juanpdeleon/proyecto_motores/Imagenes del proyecto/figura_4.jpg

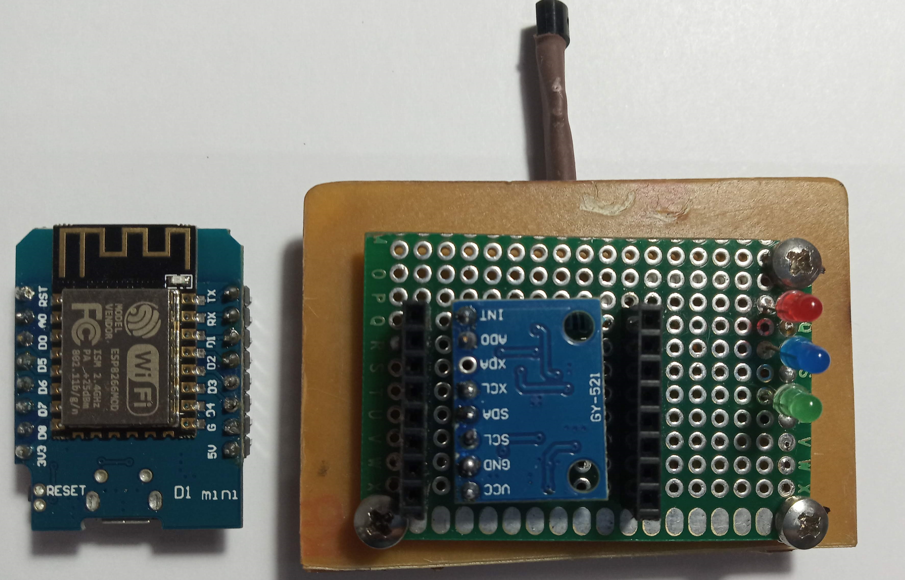
Imagenes del proyecto/figura_4.jpg
