juanpdeleon/proyecto_motores/Imagenes del proyecto/Todas/IMG_20211021_093600.jpg

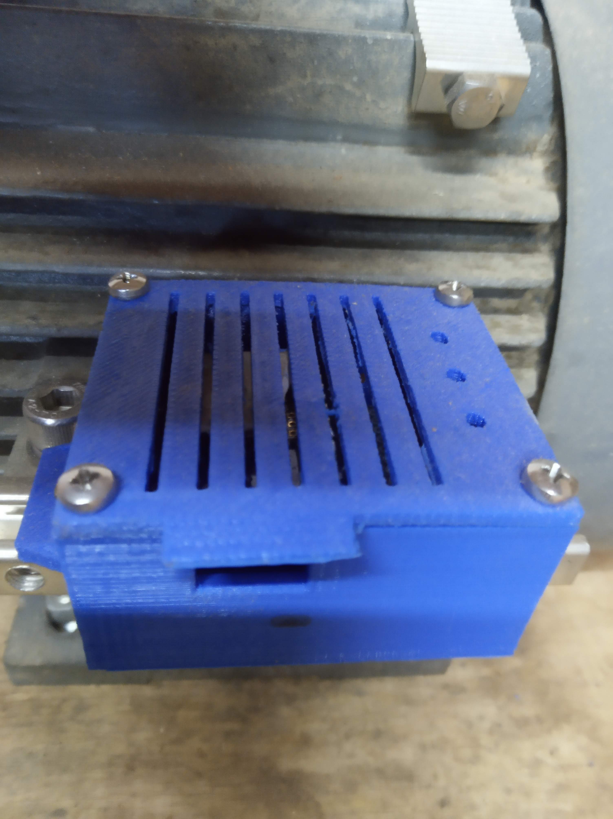
Imagenes del proyecto/Todas/IMG_20211021_093600.jpg
