juanpdeleon/proyecto_motores/README.md

## proyecto_motores
Analisis  por vibracion y temperatura de motores de corriente alterna de codigo abierto.
Trabajo de conclusion de curso, del Posgrado en Robotica e Inteligencia Artifical - UTEC - FURGS 2019-2021
