juanpdeleon/proyecto_motores/bibliografia/Lectura Complementaria/Bibliografía en línea.docx

# Bibliografía en línea

1. Instalacion de raspberry pi, con Apache , PHP, Mysql , SSh y wap
  1.1. Habilitar raspberry pi para que funcione como router (03/02/2021)
    1.1.1. https://www.raspberrypi.org/documentation/configuration/wireless/access-point-routed.md
  1.2. Servidor Apache
    1.2.1. https://www.raspberrypi.org/documentation/remote-access/web-server/apache.md
