juanpdeleon/proyecto_motores/Imagenes del proyecto/2021-03-09 18_24_29-Wifi Arduino _ MercadoLibre.com.uy.png

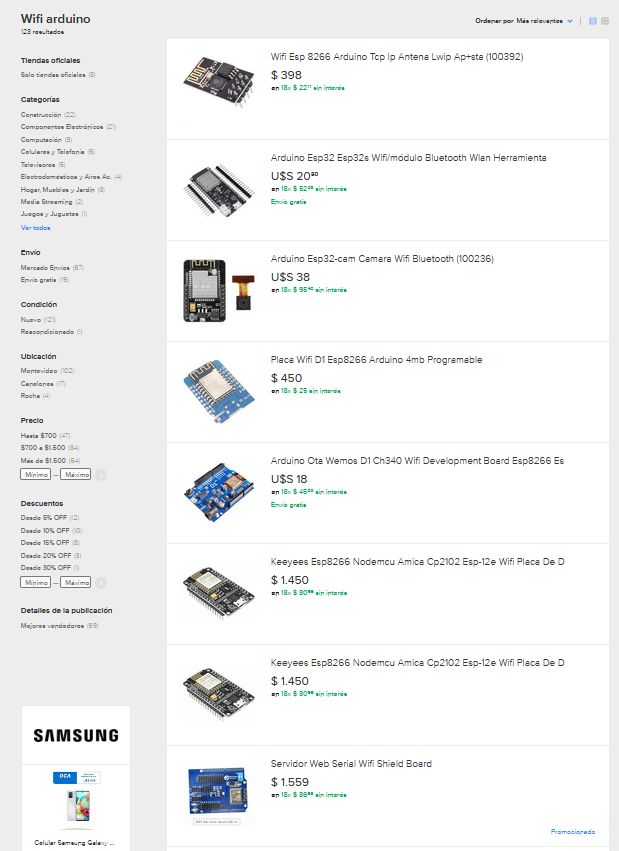
Imagenes del proyecto/2021-03-09 18_24_29-Wifi Arduino _ MercadoLibre.com.uy.png
