juanpdeleon/proyecto_motores/Imagenes del proyecto/figura9.jpg

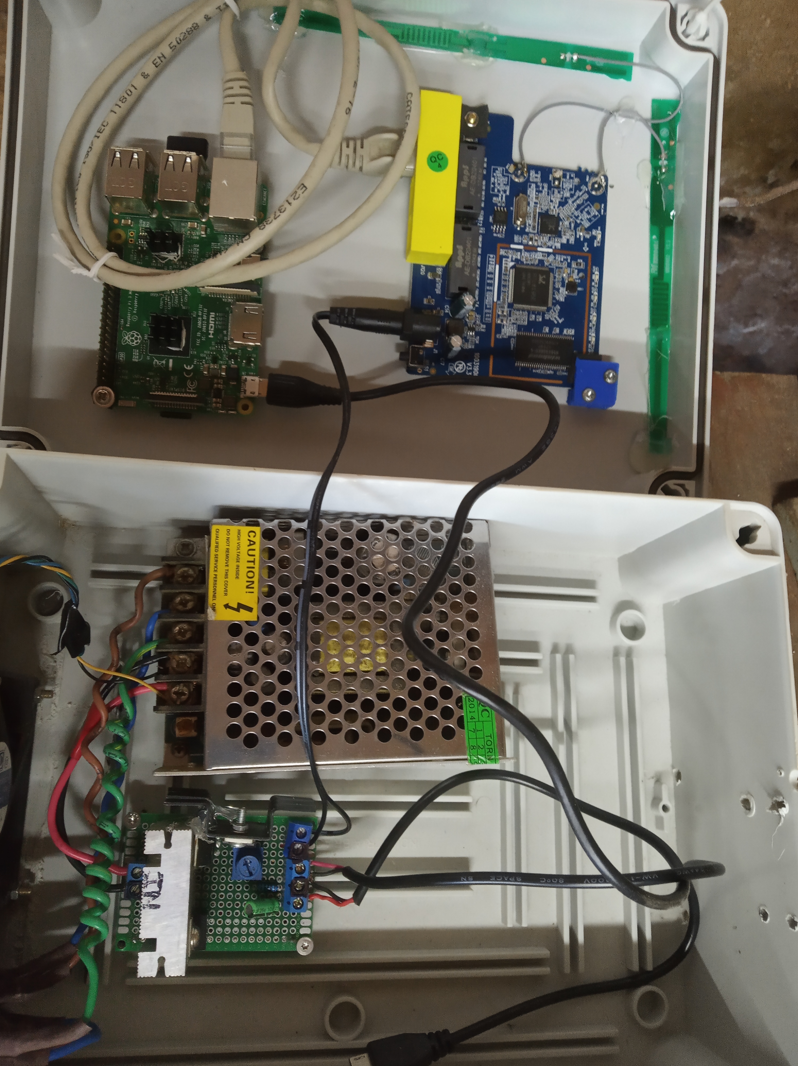
Imagenes del proyecto/figura9.jpg
