juanpdeleon/proyecto_motores/Imagenes del proyecto/Imagen_tabla.png

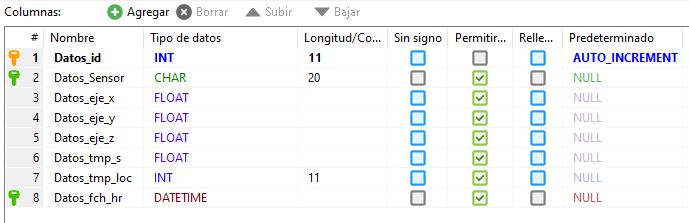
Imagenes del proyecto/Imagen_tabla.png
