juanpdeleon/proyecto_motores/Imagenes del proyecto/IMG_20210224_172307.jpg

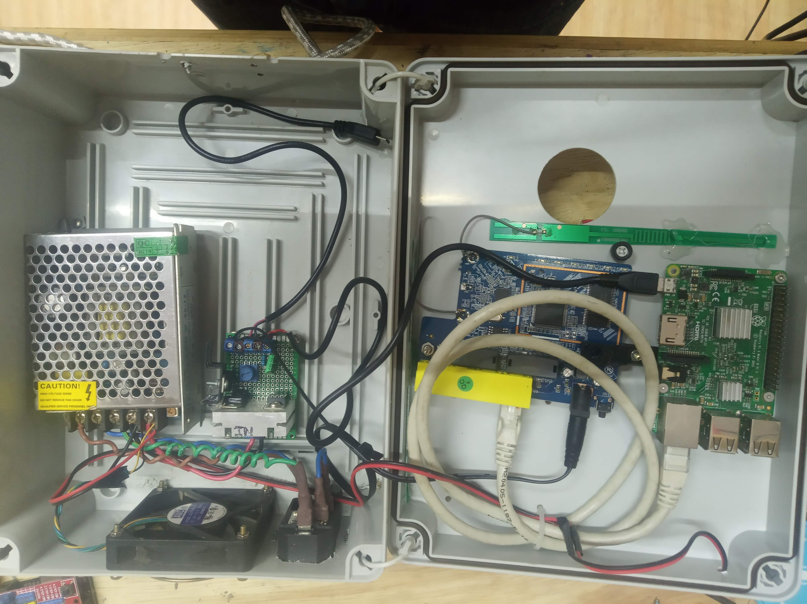
Imagenes del proyecto/IMG_20210224_172307.jpg
