juanpdeleon/proyecto_motores/Imagenes del proyecto/IMG_20211021_093633.jpg

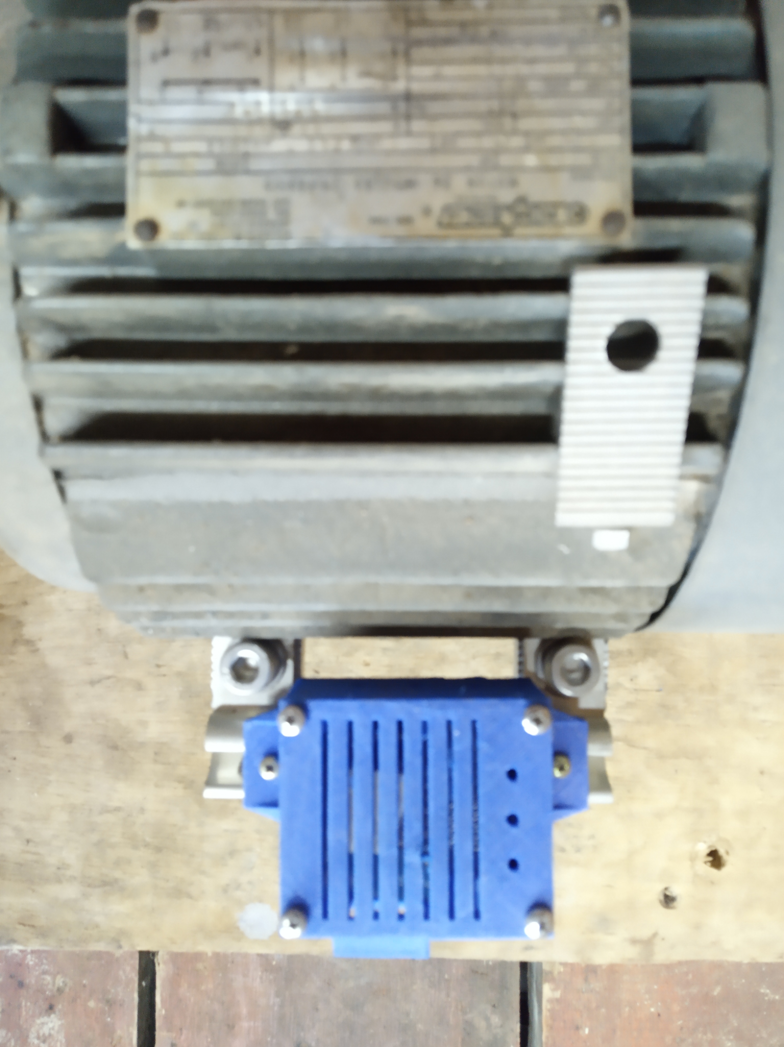
Imagenes del proyecto/IMG_20211021_093633.jpg
