juanpdeleon/proyecto_motores/Imagenes del proyecto/motor_monofasico.jpg

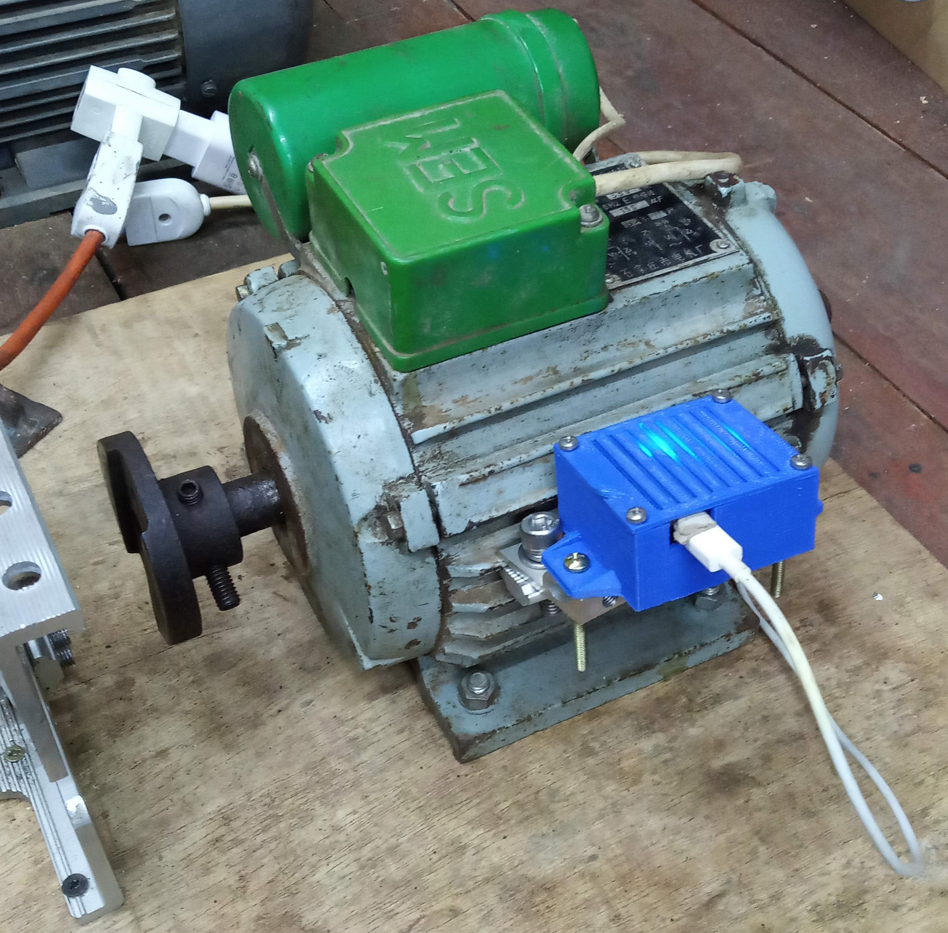
Imagenes del proyecto/motor_monofasico.jpg
