juanpdeleon/proyecto_motores/Imagenes del proyecto/set_de_datos.png

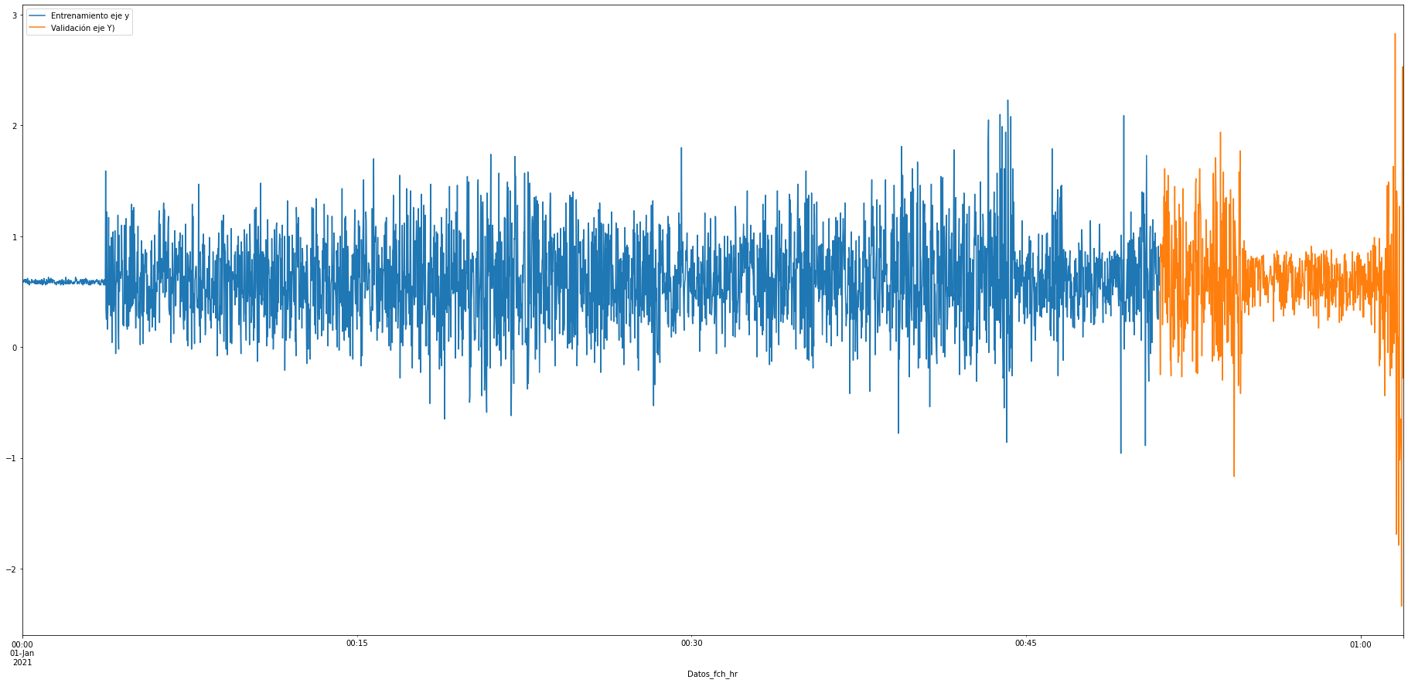
Imagenes del proyecto/set_de_datos.png
