juanpdeleon/proyecto_motores/Imagenes del proyecto/Todas/IMG_20210223_185320.jpg

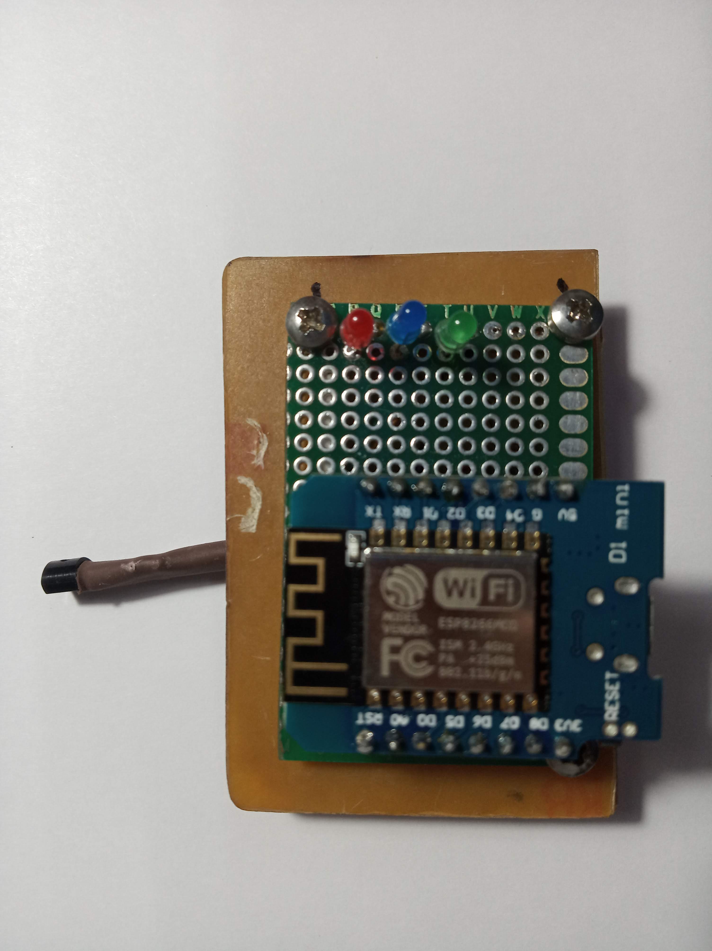
Imagenes del proyecto/Todas/IMG_20210223_185320.jpg
