juanpdeleon/proyecto_motores/Imagenes del proyecto/Todas/IMG_20210223_185329.jpg

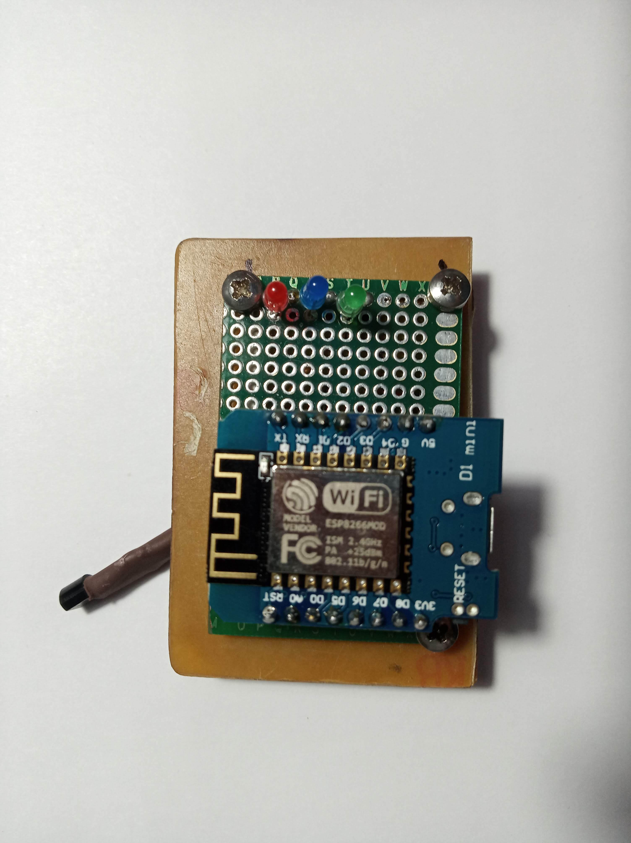
Imagenes del proyecto/Todas/IMG_20210223_185329.jpg
