juanpdeleon/proyecto_motores/Imagenes del proyecto/Todas/IMG_20210223_191959.jpg

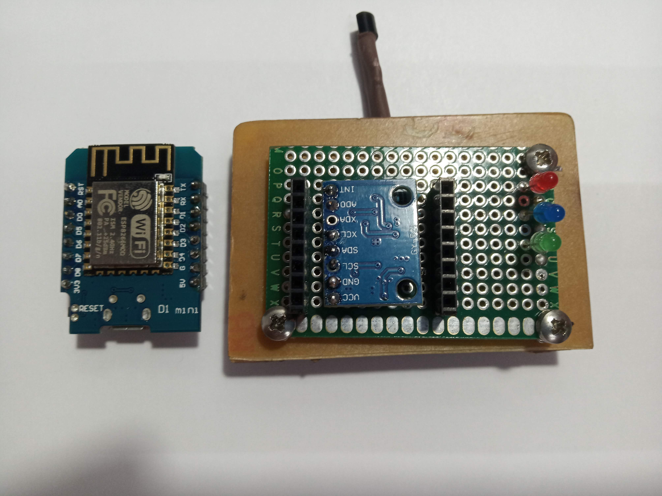
Imagenes del proyecto/Todas/IMG_20210223_191959.jpg
