juanpdeleon/proyecto_motores/Imagenes del proyecto/Todas/IMG_20210223_192011.jpg

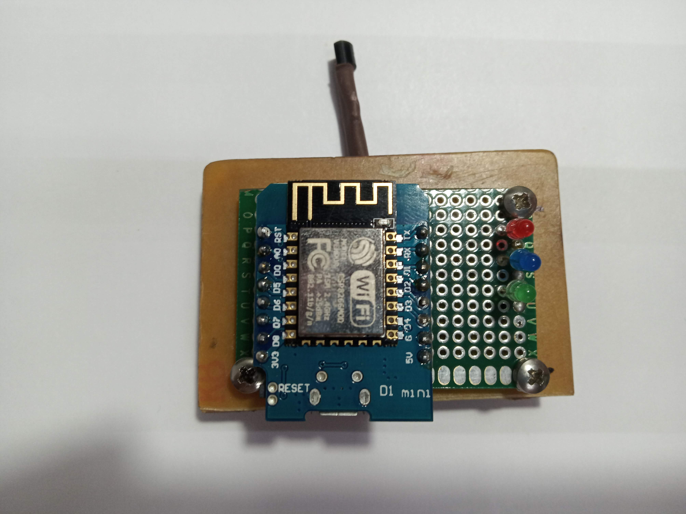
Imagenes del proyecto/Todas/IMG_20210223_192011.jpg
