juanpdeleon/proyecto_motores/Imagenes del proyecto/Todas/IMG_20210224_185208.jpg

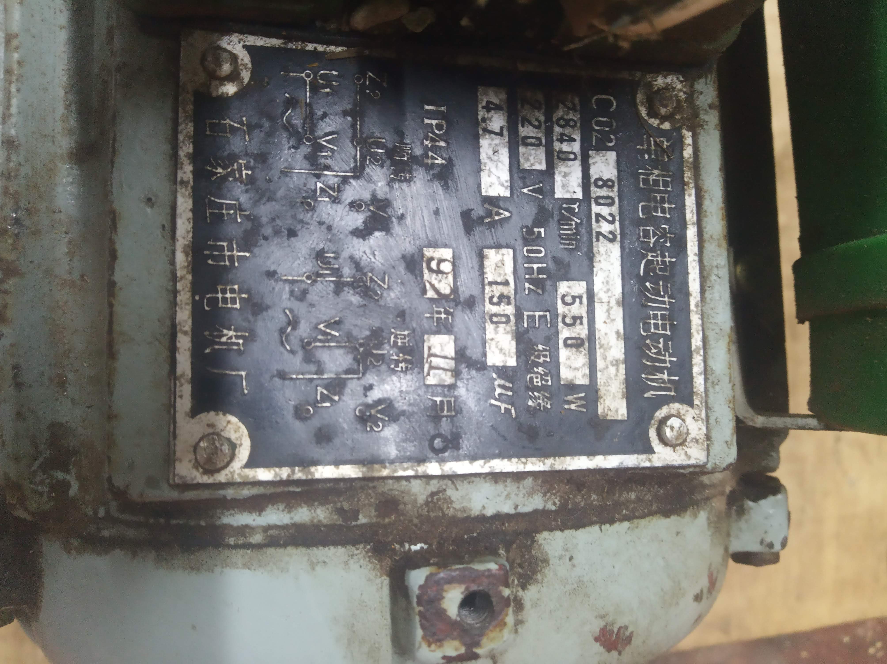
Imagenes del proyecto/Todas/IMG_20210224_185208.jpg
