juanpdeleon/proyecto_motores/Imagenes del proyecto/Todas/IMG_20210224_185932.jpg

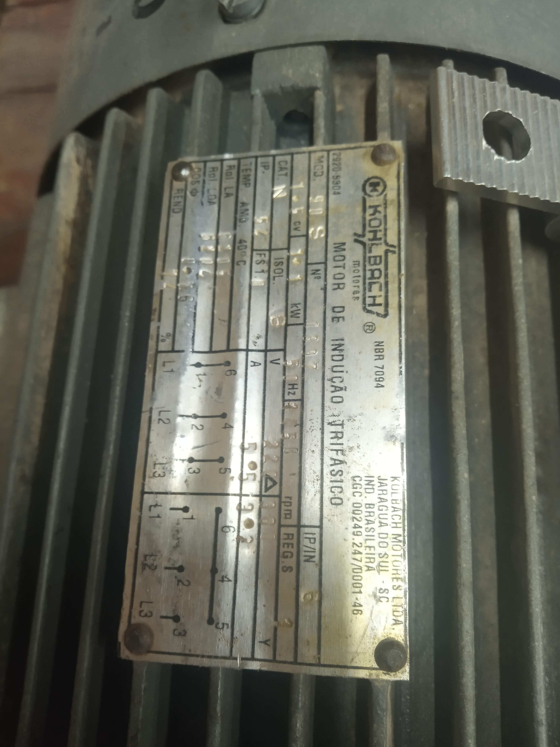
Imagenes del proyecto/Todas/IMG_20210224_185932.jpg
