juanpdeleon/proyecto_motores/Imagenes del proyecto/Todas/IMG_20210224_195514.jpg

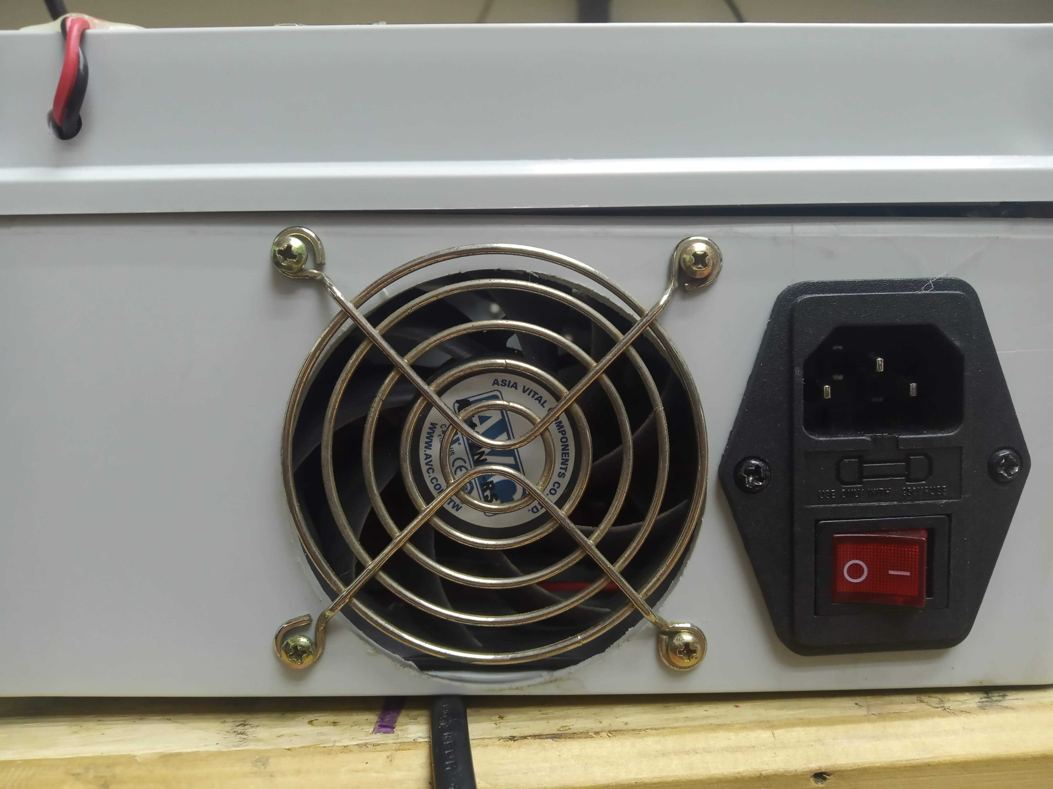
Imagenes del proyecto/Todas/IMG_20210224_195514.jpg
