juanpdeleon/proyecto_motores/Imagenes del proyecto/Todas/IMG_20210224_200654.jpg

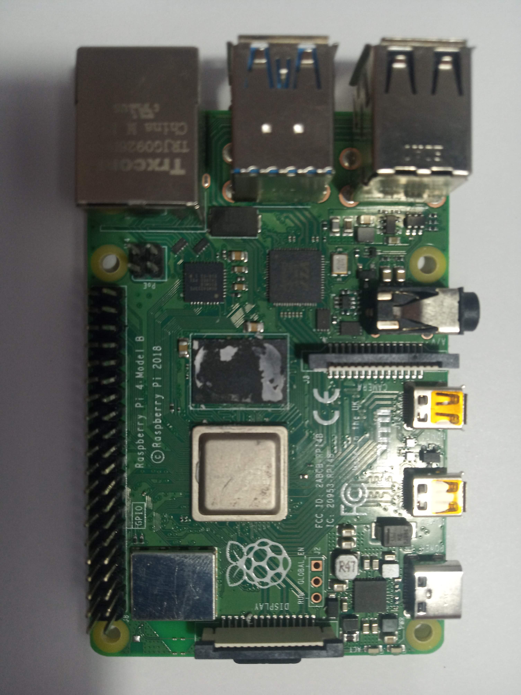
Imagenes del proyecto/Todas/IMG_20210224_200654.jpg
