juanpdeleon/proyecto_motores/Imagenes del proyecto/Todas/IMG_20210405_090809_BURST1.jpg

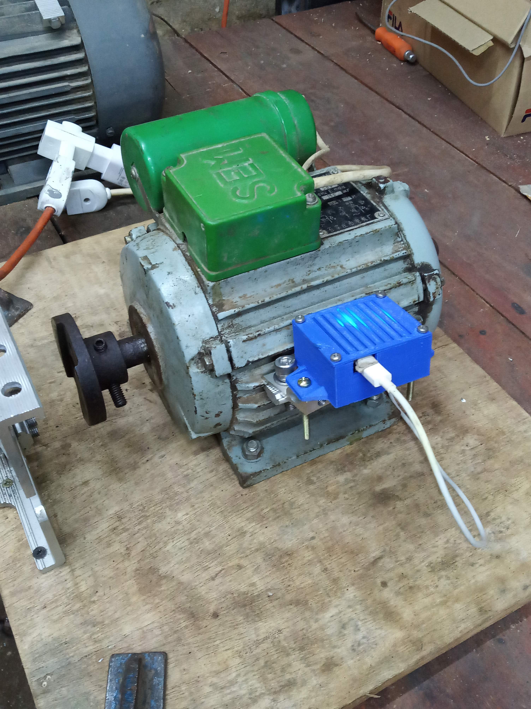
Imagenes del proyecto/Todas/IMG_20210405_090809_BURST1.jpg
