juanpdeleon/proyecto_motores/Imagenes del proyecto/Todas/IMG_20210405_104525.jpg

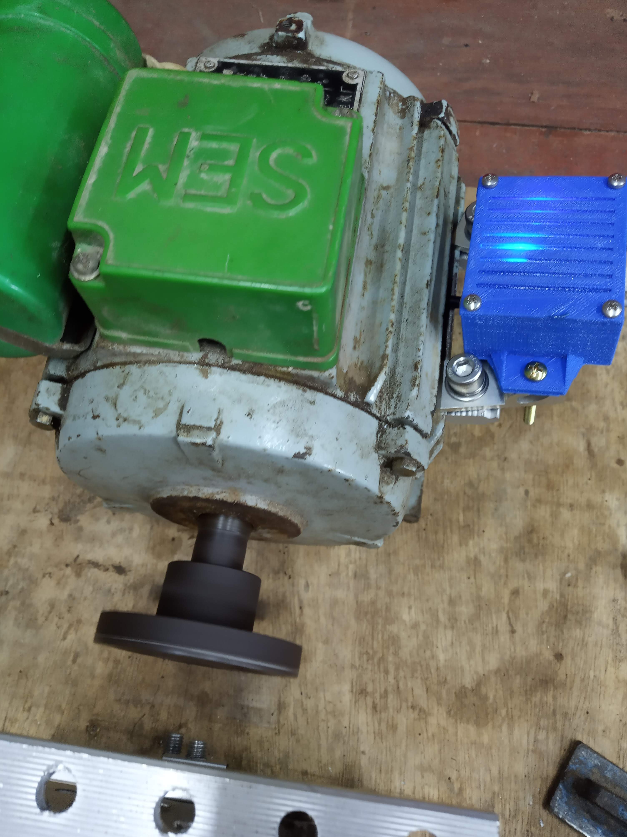
Imagenes del proyecto/Todas/IMG_20210405_104525.jpg
