juanpdeleon/proyecto_motores/Imagenes del proyecto/Todas/IMG_20210811_103844.jpg

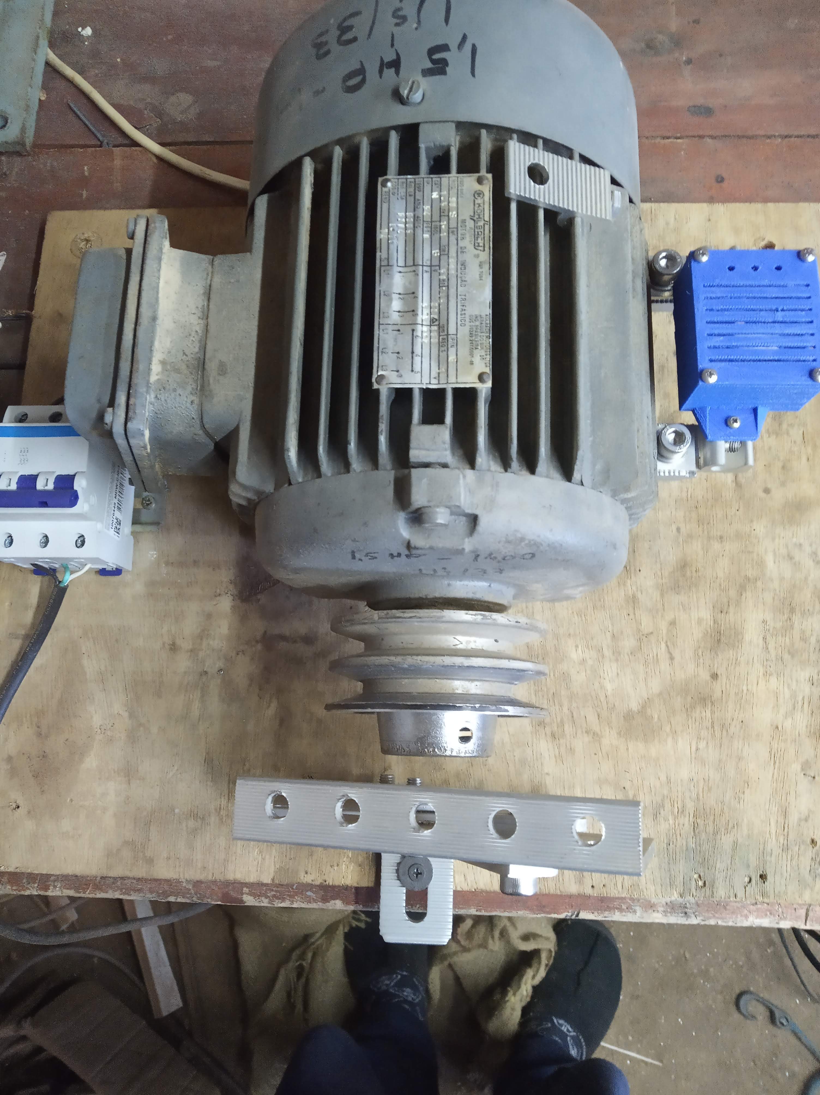
Imagenes del proyecto/Todas/IMG_20210811_103844.jpg
