juanpdeleon/proyecto_motores/Imagenes del proyecto/Todas/IMG_20210811_103934.jpg

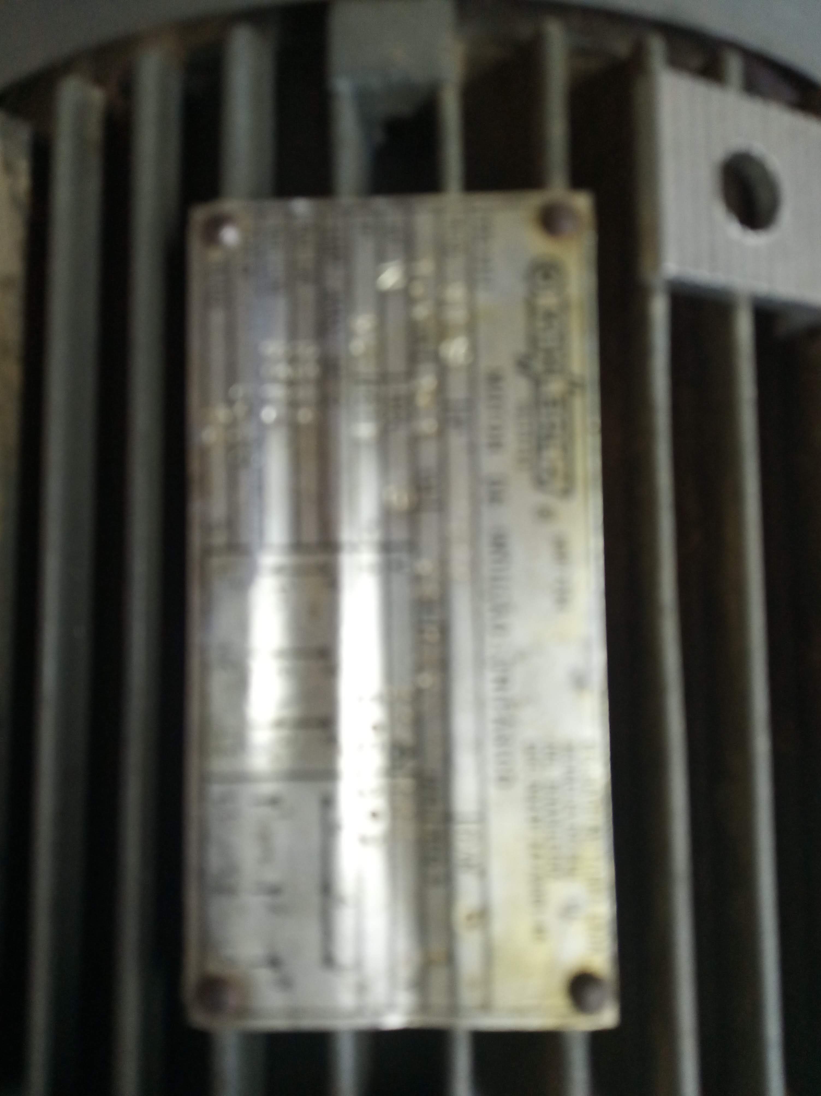
Imagenes del proyecto/Todas/IMG_20210811_103934.jpg
