juanpdeleon/proyecto_motores/Imagenes del proyecto/Todas/IMG_20211021_093509.jpg

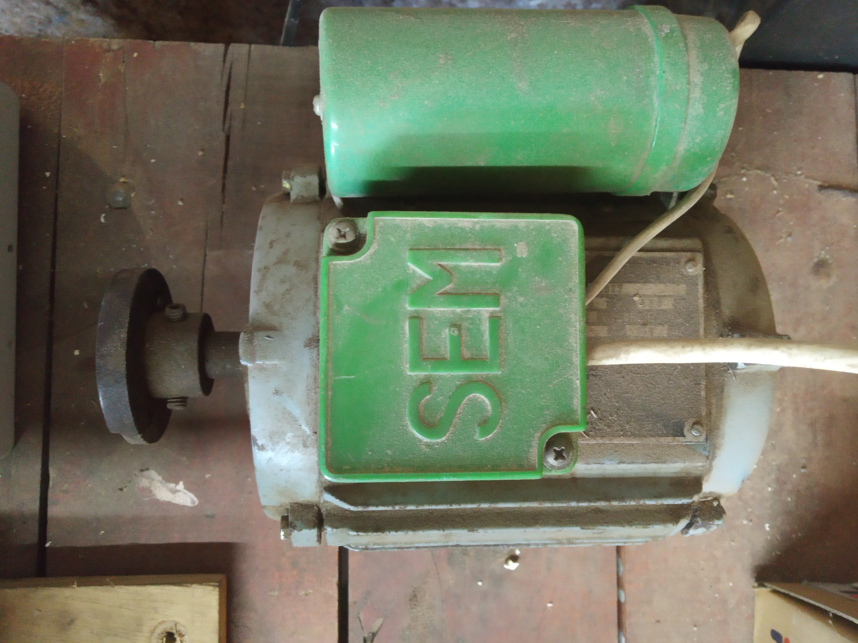
Imagenes del proyecto/Todas/IMG_20211021_093509.jpg
