juanpdeleon/proyecto_motores/(list of files, cad)

Other CAD files:
Imagenes del proyecto/introducir vibraciones_esquema.skp
