juanpdeleon/proyecto_motores/Codigos Fuente/Red Neural - LSTM/Resultados y Pruebas/Motor_trifasico_Para_Prediccion.csv

Datos_fch_hr | Datos_eje_x | Datos_eje_y | Datos_eje_z
6/5/2021 23:36 | -0.46 | 2.72 | 1.01
6/5/2021 23:36 | 2.77 | -0.15 | -7.52
6/5/2021 23:36 | 0.17 | 1.35 | -3.28
6/5/2021 23:36 | -0.41 | 4.01 | 0.02
6/5/2021 23:36 | 0.37 | 1.47 | -2.88
6/5/2021 23:36 | 0.4 | 1.16 | -4.33
6/5/2021 23:36 | -0.18 | 1.01 | -2.6
6/5/2021 23:36 | 1.21 | 0.03 | -6.5
6/5/2021 23:36 | 0.2 | 0.35 | -4.13
6/5/2021 23:36 | -0.37 | 2.16 | -2.4
6/5/2021 23:36 | 0.79 | -1.68 | -9.45
6/5/2021 23:36 | 0.61 | 1.52 | -2.69
6/5/2021 23:36 | 0.83 | 0.81 | -4.71
6/5/2021 23:36 | 2.62 | -0.49 | -7.79
6/5/2021 23:36 | 0.36 | -1.07 | -9.24
6/5/2021 23:36 | -0.18 | 2.5 | -2.03
6/5/2021 23:36 | -0.23 | -1.34 | -9.81
6/5/2021 23:36 | 2.32 | 0.09 | -7.06
6/5/2021 23:36 | 1.18 | -0.61 | -8.26
6/5/2021 23:36 | 0.11 | 2.39 | -2.89
6/5/2021 23:36 | 0.37 | 2.37 | -2.17
6/5/2021 23:36 | -0.48 | 3.66 | -1.06
6/5/2021 23:36 | 0.43 | 1.34 | -3.31
6/5/2021 23:36 | -1.65 | 2.14 | -1.04
6/5/2021 23:36 | 0.36 | 0.89 | -4.73
6/5/2021 23:36 | 0.35 | -1.98 | -9.69
6/5/2021 23:36 | 1.43 | 0.11 | -5.91
6/5/2021 23:36 | 1.05 | -0.49 | -7.12
6/5/2021 23:36 | 0.3 | -0.96 | -8.33
6/5/2021 23:36 | -0.31 | 2.51 | -0.83
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
