juanpdeleon/proyecto_motores/Codigos Fuente/Red Neural - LSTM/Resultados y Pruebas/Motor_trifasico_Para_entrenamiento.csv

Datos_fch_hr | Datos_eje_x | Datos_eje_y | Datos_eje_z
2021-01-01 0:00:00 | 0.5 | 0.59 | -5.14
2021-01-01 0:00:01 | 0.46 | 0.58 | -5.19
2021-01-01 0:00:02 | 0.46 | 0.59 | -5.17
2021-01-01 0:00:03 | 0.46 | 0.59 | -5.2
2021-01-01 0:00:04 | 0.48 | 0.59 | -5.16
2021-01-01 0:00:05 | 0.49 | 0.61 | -5.14
2021-01-01 0:00:06 | 0.49 | 0.59 | -5.16
2021-01-01 0:00:07 | 0.48 | 0.61 | -5.13
2021-01-01 0:00:08 | 0.49 | 0.6 | -5.18
2021-01-01 0:00:09 | 0.46 | 0.58 | -5.17
2021-01-01 0:00:10 | 0.47 | 0.61 | -5.2
2021-01-01 0:00:11 | 0.48 | 0.59 | -5.14
2021-01-01 0:00:12 | 0.49 | 0.58 | -5.17
2021-01-01 0:00:13 | 0.49 | 0.6 | -5.18
2021-01-01 0:00:14 | 0.48 | 0.62 | -5.17
2021-01-01 0:00:15 | 0.48 | 0.57 | -5.2
2021-01-01 0:00:16 | 0.49 | 0.59 | -5.13
2021-01-01 0:00:17 | 0.51 | 0.57 | -5.23
2021-01-01 0:00:18 | 0.46 | 0.6 | -5.18
2021-01-01 0:00:19 | 0.48 | 0.56 | -5.19
2021-01-01 0:00:20 | 0.51 | 0.59 | -5.19
2021-01-01 0:00:21 | 0.47 | 0.58 | -5.15
2021-01-01 0:00:22 | 0.51 | 0.58 | -5.17
2021-01-01 0:00:23 | 0.49 | 0.58 | -5.15
2021-01-01 0:00:24 | 0.49 | 0.58 | -5.19
2021-01-01 0:00:25 | 0.46 | 0.61 | -5.15
2021-01-01 0:00:26 | 0.51 | 0.58 | -5.2
2021-01-01 0:00:27 | 0.5 | 0.6 | -5.14
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
