juanpdeleon/proyecto_motores/Codigos Fuente/Red Neural - LSTM/Resultados y Pruebas/datos_para_entrenamiento_4.csv

Datos_fch_hr | Datos_eje_x | Datos_eje_y | Datos_eje_z
2021-01-01 2:29:12 | -0.02 | 3.48 | -0.46
2021-01-01 2:29:13 | 1.36 | -1.8 | -8.96
2021-01-01 2:29:14 | 0.92 | -1.77 | -8.89
2021-01-01 2:29:15 | 0.28 | 0.58 | -6.28
2021-01-01 2:29:16 | -0.03 | 2.46 | -0.68
2021-01-01 2:29:17 | 0.88 | -2.07 | -9.07
2021-01-01 2:29:18 | 0.95 | -1.68 | -8.43
2021-01-01 2:29:19 | 0.85 | -1.24 | -7.74
2021-01-01 2:29:20 | 1.18 | -1.53 | -8.96
2021-01-01 2:29:21 | 1.03 | -1.64 | -8.44
2021-01-01 2:29:22 | 0.91 | -1.86 | -9.11
2021-01-01 2:29:23 | 1.09 | -1.41 | -8.88
2021-01-01 2:29:24 | 0.28 | 2.22 | -2.79
2021-01-01 2:29:25 | -0.39 | 3.79 | 0.54
2021-01-01 2:29:26 | 1.26 | -1.68 | -8.74
2021-01-01 2:29:27 | 1.1 | -0.3 | -8.01
2021-01-01 2:29:28 | 0.52 | 0.5 | -6.92
2021-01-01 2:29:29 | 1.03 | -1.75 | -8.75
2021-01-01 2:29:30 | -0.35 | 4.09 | 0.48
2021-01-01 2:29:31 | -0.25 | 3.52 | 0.05
2021-01-01 2:29:32 | 0.46 | 0.81 | -4.46
2021-01-01 2:29:33 | 0.65 | -0.94 | -6.67
2021-01-01 2:29:34 | 1.28 | -1.8 | -8.93
2021-01-01 2:29:35 | 0.77 | -1.84 | -8.76
2021-01-01 2:29:36 | 0.53 | -0.74 | -8.27
2021-01-01 2:29:37 | 0.05 | 3.69 | -0.35
2021-01-01 2:29:38 | 0.32 | 0.42 | -4.46
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
