juanpdeleon/proyecto_motores/Imagenes del proyecto/REsultado_400epocas_batch16.png

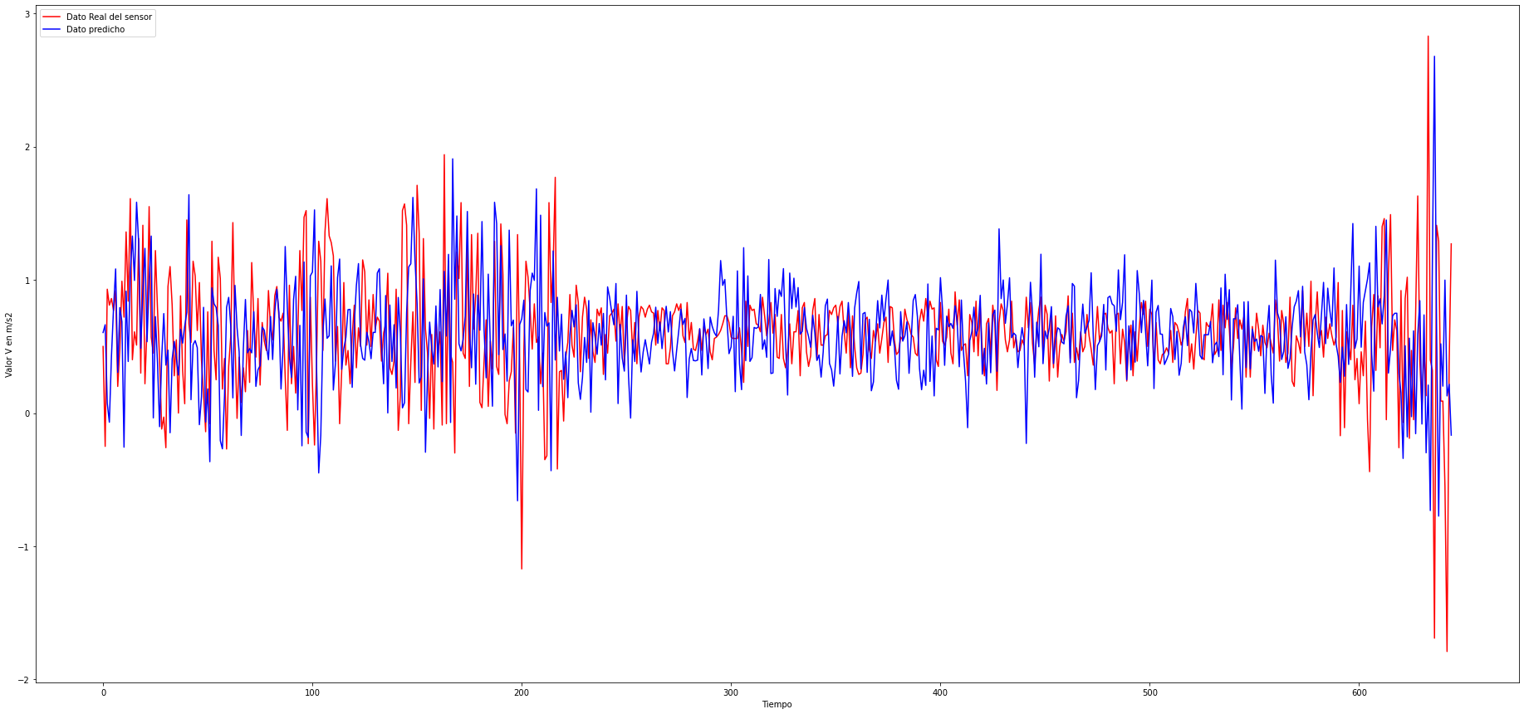
Imagenes del proyecto/REsultado_400epocas_batch16.png
