juanpdeleon/proyecto_motores/Imagenes del proyecto/REsultado_400epocas_batch32.png

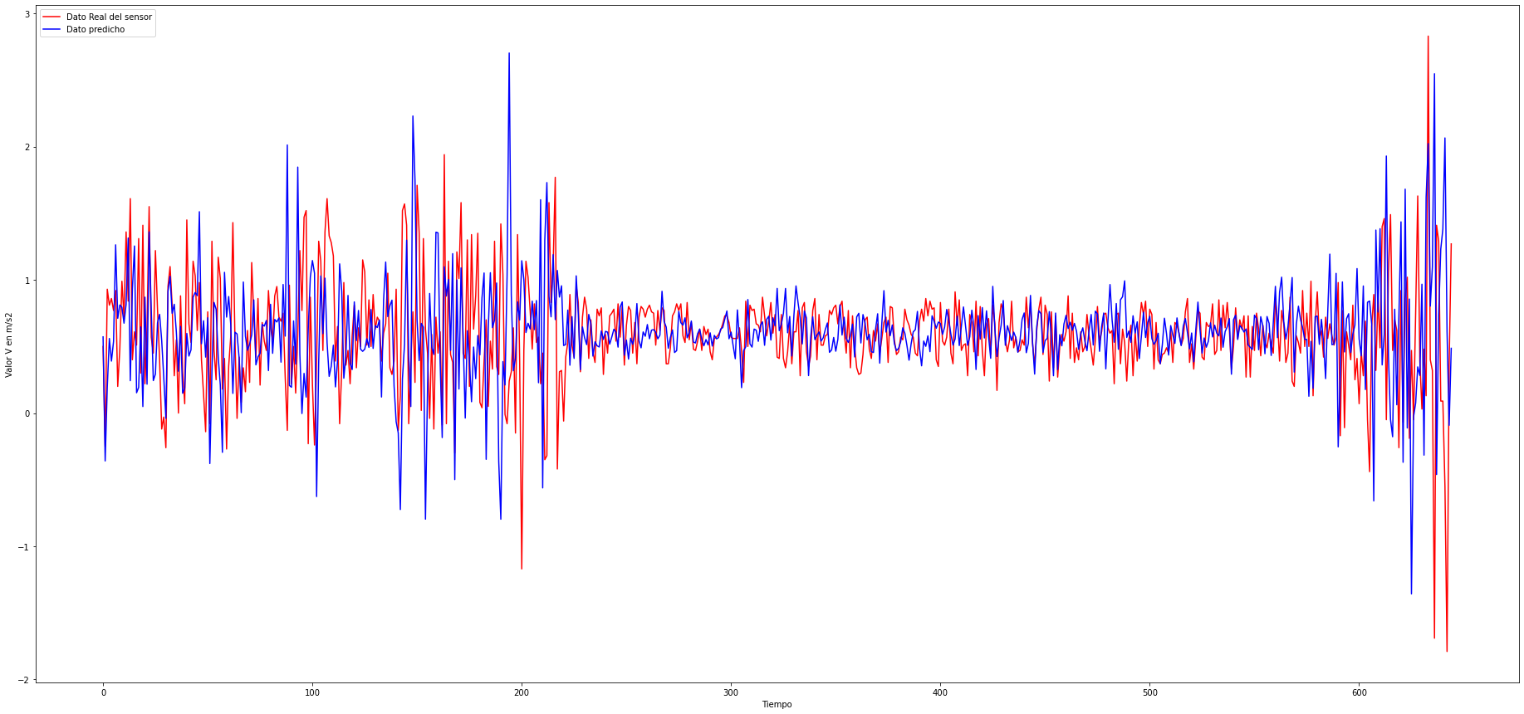
Imagenes del proyecto/REsultado_400epocas_batch32.png
