juanpdeleon/proyecto_motores/Imagenes del proyecto/REsultado_400epocas_batch32_32entradas.png

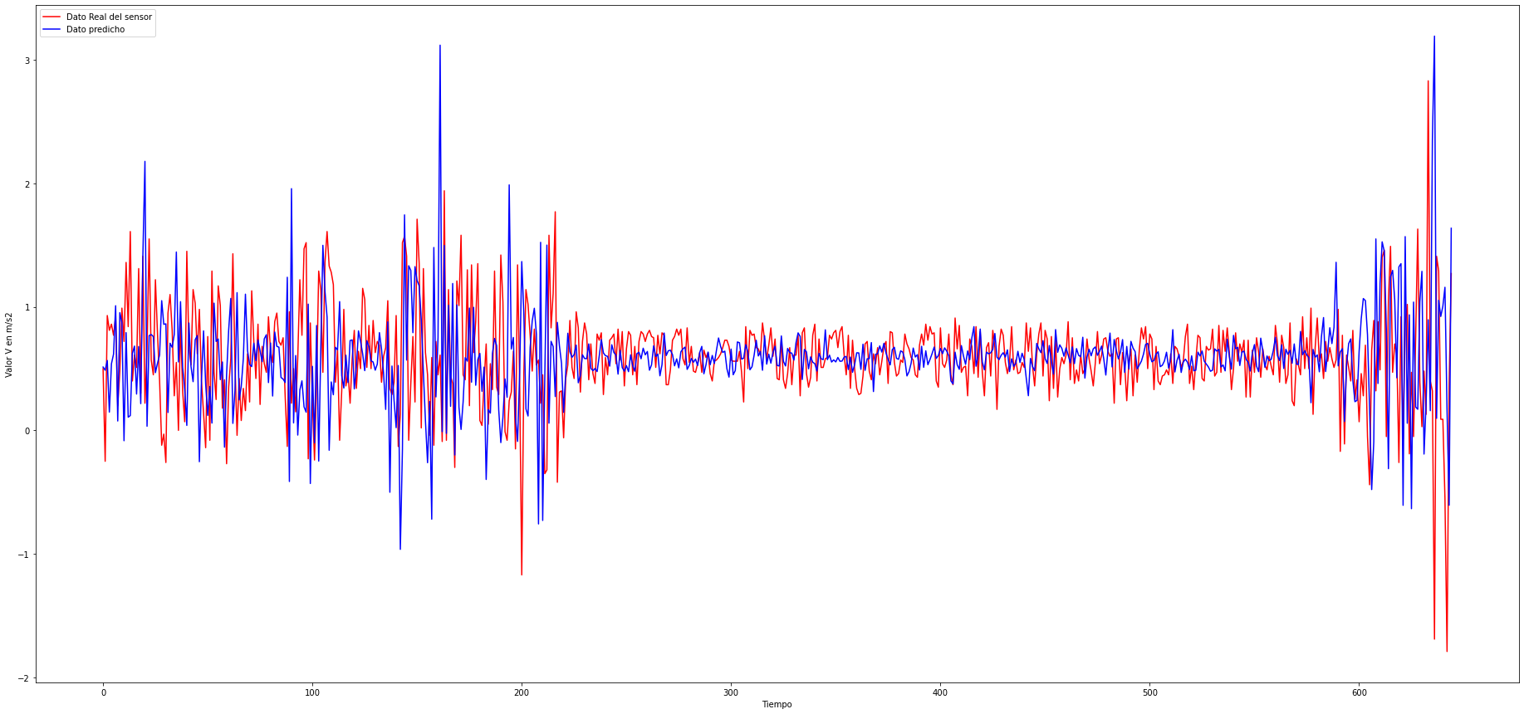
Imagenes del proyecto/REsultado_400epocas_batch32_32entradas.png
