juanpdeleon/proyecto_motores/Imagenes del proyecto/REsultado_600epocas_batch32.png

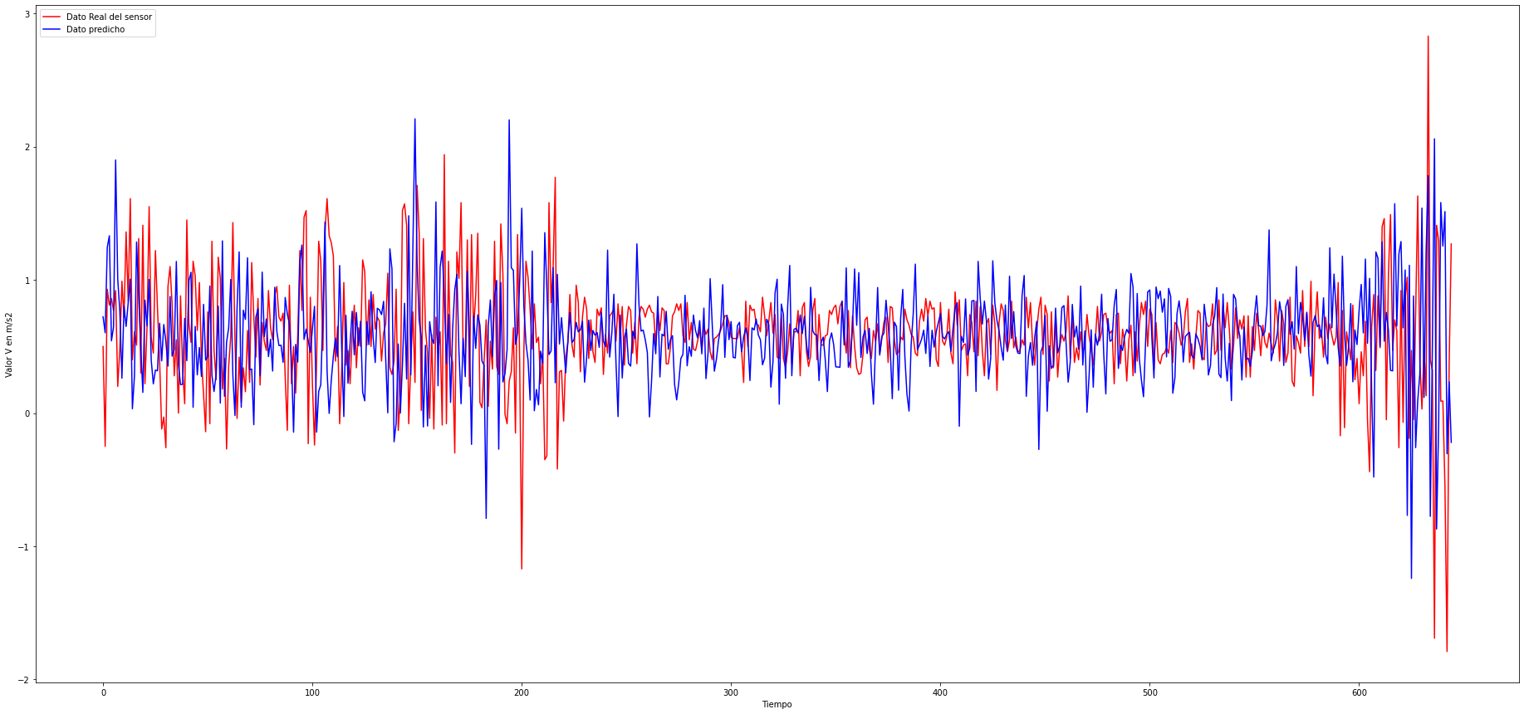
Imagenes del proyecto/REsultado_600epocas_batch32.png
