juanpdeleon/proyecto_motores/kicad de pcb/sensor_motores/sensor_motores.kicad_pcb

## KiCad design kicad de pcb/sensor_motores/sensor_motores.kicad_pcb (2022-01-25)

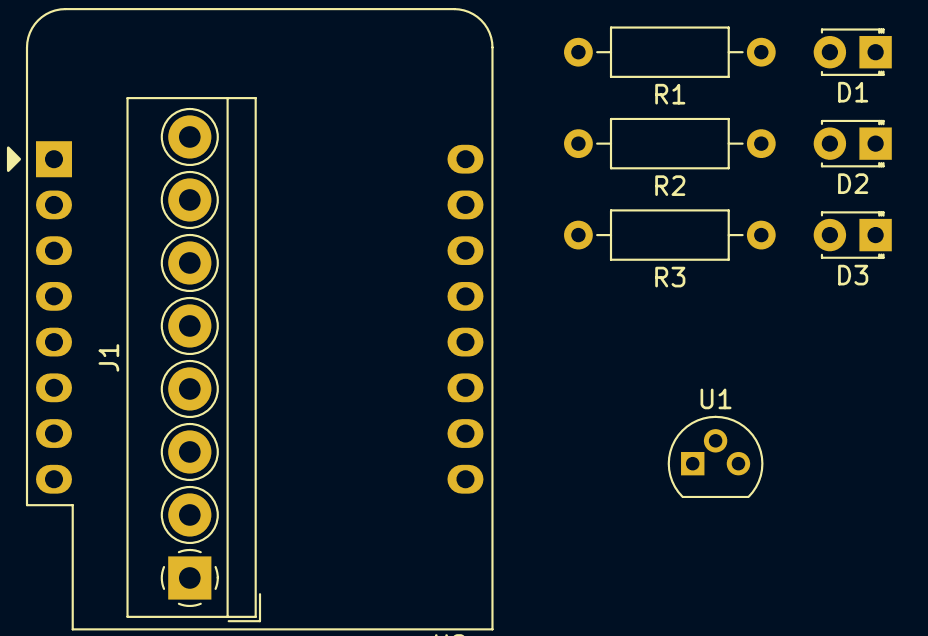
[picture p73: board sensor_motores.kicad_pcb from above]

Board: 2 copper layers, 9 parts (0 on the bottom side), 11 nets, no tracks yet.

Parts:
D1, D2, D3: LED; LED_D1.8mm_W3.3mm_H2.4mm
J1: MPU-6050; TerminalBlock_4Ucon_1x08_P3.50mm_Horizontal
R1, R2, R3: R; R_Axial_DIN0207_L6.3mm_D2.5mm_P10.16mm_Horizontal
U1: LM35-LP; TO-92
U2: WeMos_D1_mini; WEMOS_D1_mini_light

Connections:
unnamed: D1.1, D2.1, D3.1, J1.2, U1.3, U2.10
unnamed: D1.2, R1.1
unnamed: D2.2, R2.1
unnamed: D3.2, R3.1
unnamed: J1.1, U1.1, U2.9
unnamed: J1.3, U2.14
unnamed: J1.4, U2.13
unnamed: R1.2, U2.3
unnamed: R2.2, U2.4
unnamed: R3.2, U2.5
unnamed: U1.2, U2.2
